tonnerre33/Livolo_EU_1Gang_1way/Livolo_EU_1Gang_1way.pdf

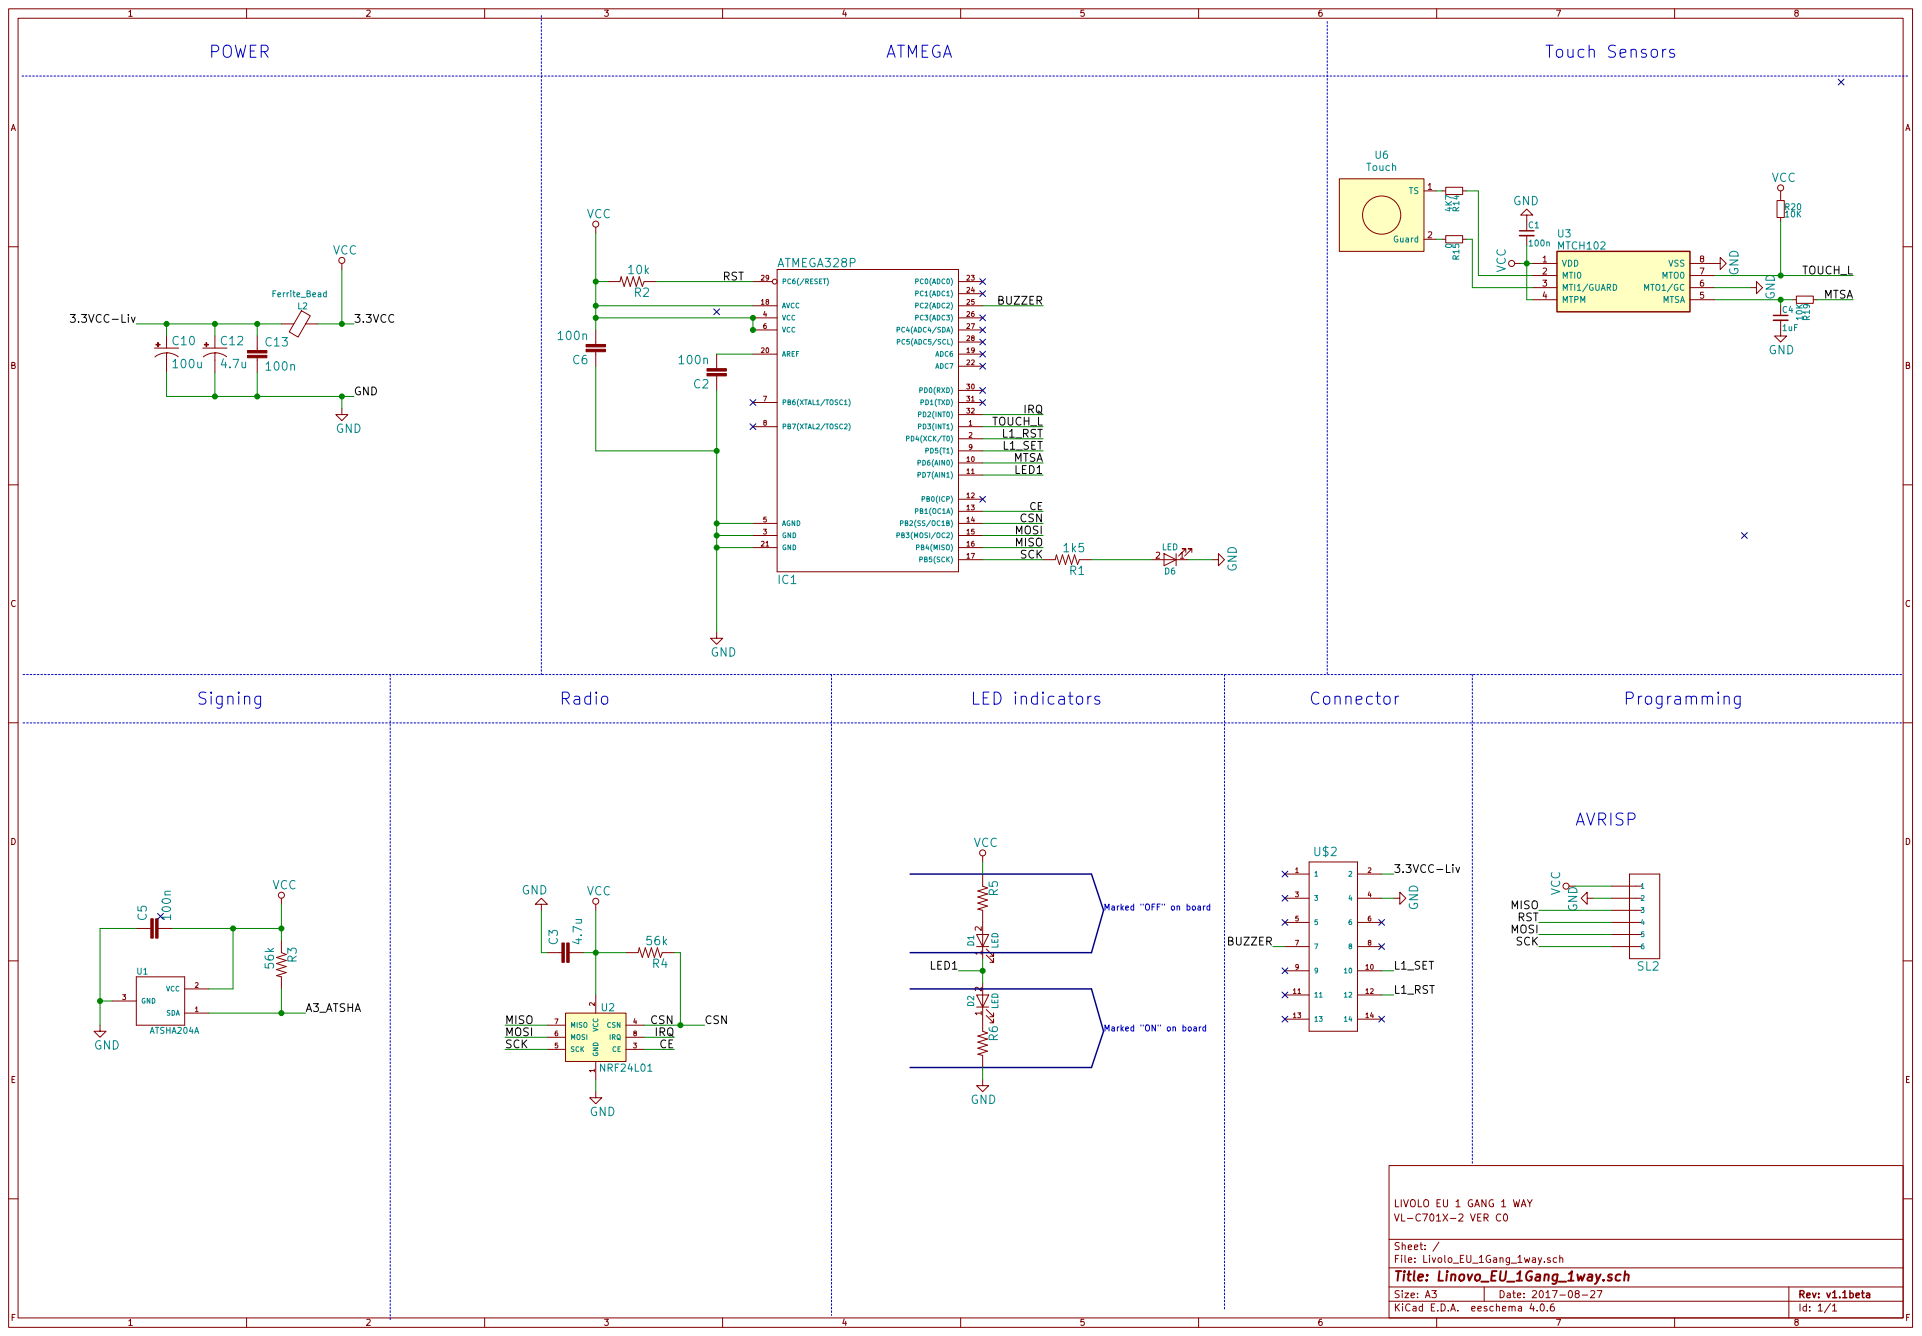
[picture p1: page 1]

TOUCH_L
L1_RST
L1_SET

Marked "OFF" on board Marked "ON" on board

2 CE 3 CSN 4 SCK 5 MOSI 6 MISO 7

File: Livolo_EU_1Gang_1way.sch Sheet: / VL-C701X-2 VER C0
