tonnerre33/Livolo_EU_1Gang_1way/(list of files, drawings)

Other design files:
Livolo_EU_1Gang_1way.dsn
