tonnerre33/Livolo_EU_1Gang_1way/Livolo_EU_1Gang_1way.kicad_pcb

## KiCad design Livolo_EU_1Gang_1way.kicad_pcb (2017-08-27)

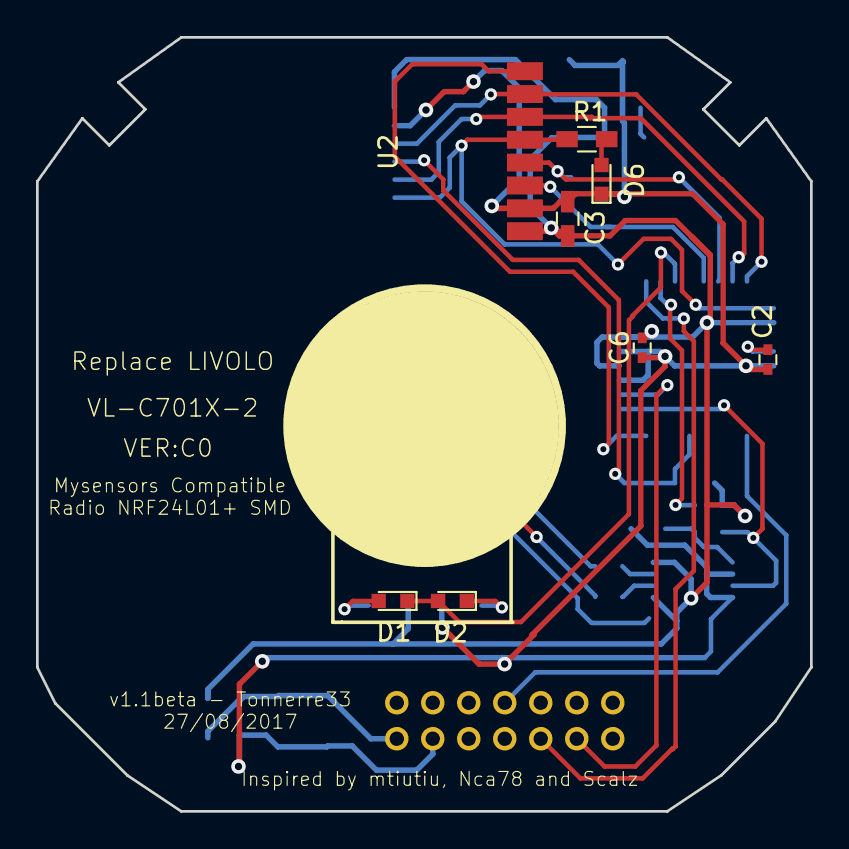
[picture p2: board Livolo_EU_1Gang_1way.kicad_pcb from above]

Board: 2 copper layers, 43.0 x 43.0 mm, 30 parts (0 on the bottom side), 26 nets.

Parts:
C1, C5, C13: 100n; C_0603_HandSoldering
C2, C6: 100n; C_0402
C3: 4.7u; C_0603_HandSoldering
C4: 1uF; C_0603_HandSoldering
C10: 100u; EIA3216
C12: 4.7u; EIA3216
D1, D2, D6: LED; LED_0603
IC1: ATMEGA328P; TQFP32-08
L2: Ferrite_Bead; R_0603_HandSoldering
R1: 1k5; R_0603_HandSoldering
R2: 10k; R_0603_HandSoldering
R3, R4: 56k; R_0603_HandSoldering
R5, R6: R_0603_HandSoldering
R14: 4K7; R_0603
R15: 0; R_0603
R19, R20: 10K; R_0603
SL2: 1X06-1MM
U1: ATSHA204A; SOT23-3
U2: NRF24L01; NRF24L01-SMD
U3: MTCH102; MSOP-8_3x3mm_Pitch0.65mm
U6: Touch; livolo_ts_guard
U$2: CONNECTOR_02_X_072MM_SPACING; CONNECTOR_02_X_07_2MM

Connections:
/3.3VCC-Liv: C10.+, C12.+, C13.1, L2.2, U$2.2
/A3_ATSHA: R3.2, U1.1
/BUZZER: IC1.25, U$2.7
/CE: IC1.13, U2.3
/CSN: IC1.14, R4.1, U2.4
/IRQ: IC1.32, U2.8
/L1_RST: IC1.2, U$2.12
/L1_SET: IC1.9, U$2.10
/LED1: D1.1, D2.2, IC1.11
/MISO: IC1.16, SL2.3, U2.7
/MOSI: IC1.15, SL2.5, U2.6
/MTSA: IC1.10, R19.1
/RST: IC1.29, R2.1, SL2.4
/SCK: IC1.17, R1.2, SL2.6, U2.5
/TOUCH_L: IC1.1, R20.2, U3.7
GND: C1.1, C2.1, C3.1, C4.2, C5.1, C6.1, C10.-, C12.-, C13.2, D6.1, IC1.3, IC1.5, IC1.21, R6.2, SL2.2, U1.3, U2.1, U3.6, U3.8, U$2.4
unnamed: C2.2, IC1.20
unnamed: C4.1, R19.2, U3.5
unnamed: D1.2, R5.2
unnamed: D2.1, R6.1
unnamed: D6.2, R1.1
unnamed: R14.1, U3.2
unnamed: R14.2, U6.1
unnamed: R15.1, U3.3
unnamed: R15.2, U6.2
VCC: C1.2, C3.2, C5.2, C6.2, IC1.4, IC1.6, IC1.18, L2.1, R2.2, R3.1, R4.2, R5.1, R20.1, SL2.1, U1.2, U2.2, U3.1, U3.4
