tonnerre33/Livolo_EU_1Gang_1way/(commit log)

2017-08-08 adding Gerber & pdf
    [Livolo_EU_1Gang_1way-B.Mask.gbs, Livolo_EU_1Gang_1way-B.Paste.gbp, Livolo_EU_1Gang_1way-B.SilkS.gbo, Livolo_EU_1Gang_1way-Bottom.gbl, Livolo_EU_1Gang_1way-Edge.Cuts.gm1, Livolo_EU_1Gang_1way-F.Mask.gts, Livolo_EU_1Gang_1way-F.Paste.gtp, Livolo_EU_1Gang_1way-F.SilkS.gto]
2017-08-27 move MTSA pin to a PWM pin of the ATMEGA
    [Livolo_EU_1Gang_1way-B.Mask.gbs, Livolo_EU_1Gang_1way-B.Paste.gbp, Livolo_EU_1Gang_1way-B.SilkS.gbo, Livolo_EU_1Gang_1way-Bottom.gbl, Livolo_EU_1Gang_1way-Edge.Cuts.gm1, Livolo_EU_1Gang_1way-F.Mask.gts, Livolo_EU_1Gang_1way-F.Paste.gtp, Livolo_EU_1Gang_1way-F.SilkS.gto]
2017-08-27 remove resistor for guard
    [Livolo_EU_1Gang_1way-B.Mask.gbs, Livolo_EU_1Gang_1way-B.Paste.gbp, Livolo_EU_1Gang_1way-B.SilkS.gbo, Livolo_EU_1Gang_1way-Bottom.gbl, Livolo_EU_1Gang_1way-Edge.Cuts.gm1, Livolo_EU_1Gang_1way-F.Mask.gts, Livolo_EU_1Gang_1way-F.Paste.gtp, Livolo_EU_1Gang_1way-F.SilkS.gto]
